Slinta/Hardware/Black_STM32F407VET6/STM32F407VET6.kicad_pcb

## KiCad design Black_STM32F407VET6/STM32F407VET6.kicad_pcb (2019-08-13)

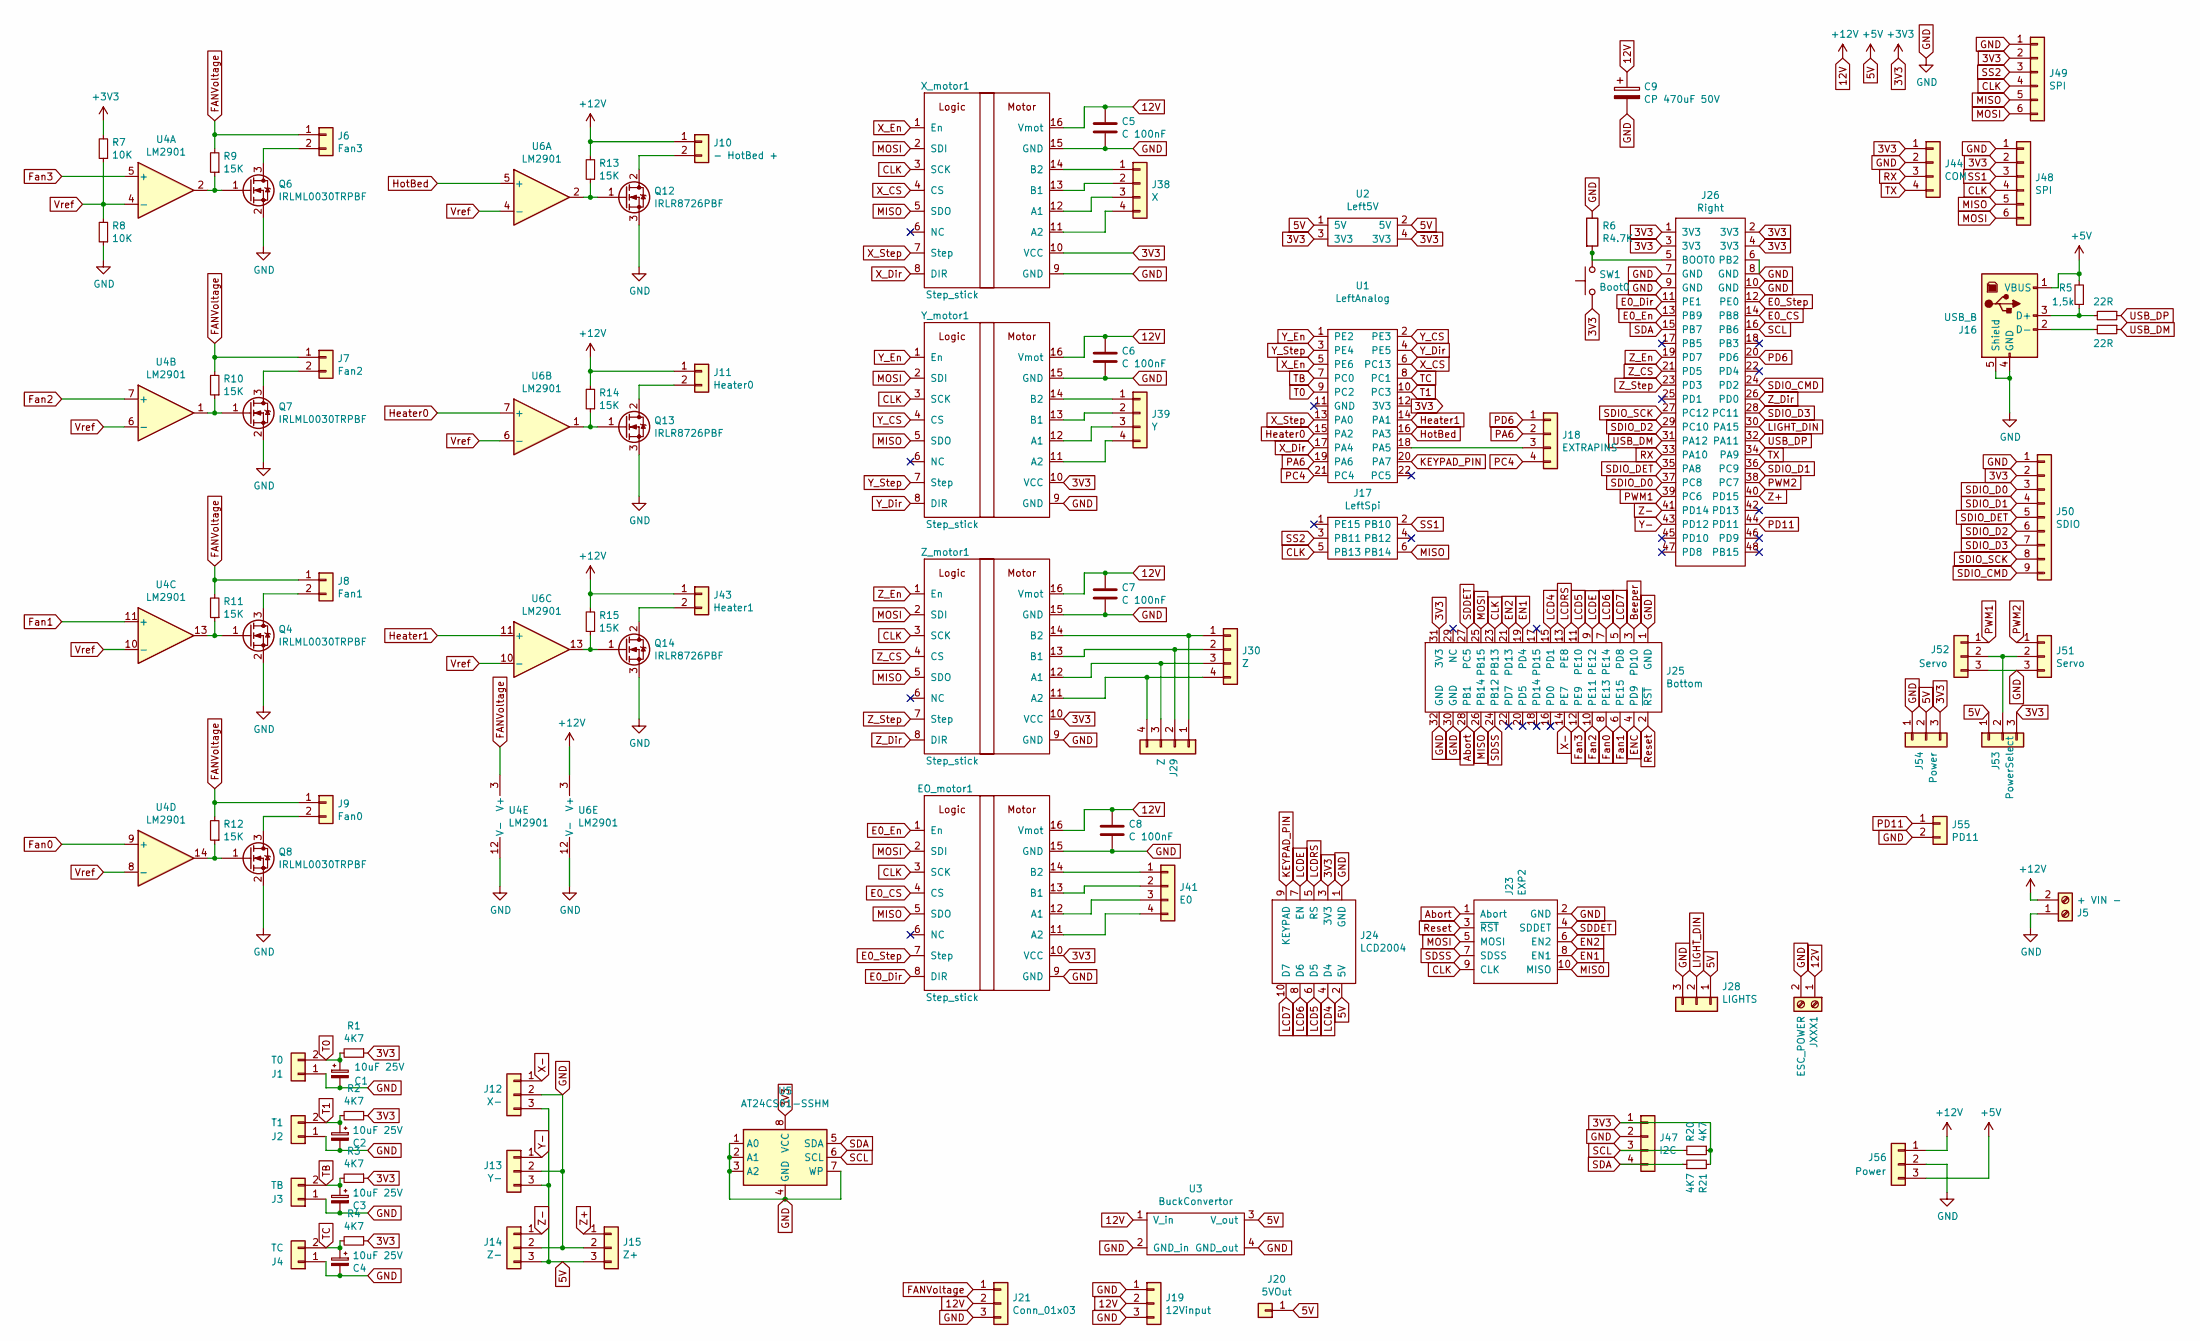
[picture p1: schematic STM32F407VET6.sch]

Parts:
C1, C2, C3, C4: 10uF 25V; CP_Radial_D4.0mm_P2.00mm
C5, C6, C7, C8: C 100nF; C_Disc_D3.4mm_W2.1mm_P2.50mm
C9: CP 470uF 50V; CP_Radial_D10.0mm_P5.00mm
EO_motor1: Step_stick; Motor
J1: T0; JST_XH_B2B-XH-AM_1x02_P2.50mm_Vertical
J2: T1; JST_XH_B2B-XH-AM_1x02_P2.50mm_Vertical
J3: TB; JST_XH_B2B-XH-AM_1x02_P2.50mm_Vertical
J4: TC; JST_XH_B2B-XH-AM_1x02_P2.50mm_Vertical
J5: + VIN -; KF7.62_2P
J6: Fan3; JST_XH_B2B-XH-AM_1x02_P2.50mm_Vertical
J7: Fan2; JST_XH_B2B-XH-AM_1x02_P2.50mm_Vertical
J8: Fan1; JST_XH_B2B-XH-AM_1x02_P2.50mm_Vertical
J9: Fan0; JST_XH_B2B-XH-AM_1x02_P2.50mm_Vertical
J10: - HotBed +; KF7.62_2P
J11: Heater0; TerminalBlock_bornier-2_P5.08mm
J12: X-; JST_XH_B3B-XH-A_1x03_P2.50mm_Vertical
J13: Y-; JST_XH_B3B-XH-A_1x03_P2.50mm_Vertical
J14: Z-; JST_XH_B3B-XH-A_1x03_P2.50mm_Vertical
J15: Z+; JST_XH_B3B-XH-A_1x03_P2.50mm_Vertical
J16: USB_B; USB_B_OST_USB-B1HSxx_Horizontal
J17: LeftSpi; PinHeader_2x03_P2.54mm_Vertical
J18: EXTRAPINS; PinHeader_1x04_P2.54mm_Vertical
J19: 12Vinput; PinHeader_1x03_P2.54mm_Vertical
J20: 5VOut; PinHeader_1x01_P2.54mm_Vertical
J21: Conn_01x03; PinHeader_1x03_P2.54mm_Vertical
J23: EXP2; IDC-Header_2x05_P2.54mm_Vertical
J24: LCD2004; IDC-Header_2x05_P2.54mm_Vertical
J25: Bottom; PinSocket_2x16_P2.54mm_Vertical
J26: Right; PinSocket_2x24_P2.54mm_Vertical
J28: LIGHTS; JST_XH_B3B-XH-A_1x03_P2.50mm_Vertical
J29, J30: Z; JST_XH_B4B-XH-A_1x04_P2.50mm_Vertical
J38: X; JST_XH_B4B-XH-A_1x04_P2.50mm_Vertical
J39: Y; JST_XH_B4B-XH-A_1x04_P2.50mm_Vertical
J41: E0; JST_XH_B4B-XH-A_1x04_P2.50mm_Vertical
J43: Heater1; TerminalBlock_bornier-2_P5.08mm
J44: COM; PinHeader_1x04_P2.54mm_Vertical
J47: I2C; PinHeader_1x04_P2.54mm_Vertical
J48, J49: SPI; PinHeader_1x06_P2.54mm_Vertical
J50: SDIO; JST_XH_B9B-XH-A_1x09_P2.50mm_Vertical
J51, J52: Servo; PinHeader_1x03_P2.54mm_Vertical
J53: PowerSelect; PinHeader_1x03_P2.54mm_Vertical
J54, J56: Power; PinHeader_1x03_P2.54mm_Vertical
J55: PD11; PinHeader_1x02_P2.54mm_Vertical
JXXX1: ESC_POWER; TerminalBlock_bornier-2_P5.08mm
Q4, Q6, Q7, Q8: IRLML0030TRPBF; SOT-23
Q12, Q13, Q14: IRLR8726PBF; TO-252-2
R1, R2, R3, R4, R20, R21: 4K7; R_0603_1608Metric
R5: 1,5k; R_0603_1608Metric
R6: R4.7K; R_0603_1608Metric
R7, R8: 10K; R_0603_1608Metric
R9, R10, R11, R12, R13, R14, R15: 15K; R_0603_1608Metric
R18, R19: 22R; R_0603_1608Metric
SW1: Boot0; SW_PUSH_6mm_H5mm
U1: LeftAnalog; PinHeader_2x11_P2.54mm_Vertical
U2: Left5V; PinHeader_2x02_P2.54mm_Vertical
U3: BuckConvertor; MP2307Buck
U4, U6: LM2901; SOIC-14_3.9x8.7mm_P1.27mm
U5: AT24CS01-SSHM; SOIC-8_3.9x4.9mm_P1.27mm
X_motor1: Step_stick; Motor
Y_motor1: Step_stick; Motor
Z_motor1: Step_stick; Motor

Connections:
3V3: EO_motor1.10 (VCC), J24.3 (3V3), J25.31 (3V3), J26.1 (3V3), J26.2 (3V3), J26.3 (3V3), J26.4 (3V3), J44.1, J47.1, J48.2, J49.2, J50.2, J53.3, J54.3, R1.1, R2.1, R3.1, R4.1, R7.2, R20.1, R21.2, SW1.1, U1.12 (3V3), U2.3 (3V3), U2.4 (3V3), U5.8 (VCC), X_motor1.10 (VCC), Y_motor1.10 (VCC), Z_motor1.10 (VCC)
5V: J12.3, J13.3, J14.3, J15.3, J16.1 (VBUS), J20.1, J24.2 (5V), J28.1, J53.1, J54.2, J56.3, R5.2, U2.1 (5V), U2.2 (5V), U3.3 (V_out)
12V: C5.1, C6.1, C7.1, C8.1, C9.1, EO_motor1.16 (Vmot), J5.2, J10.1, J11.1, J19.2, J21.2, J43.1, J56.1, JXXX1.1, R13.2, R14.2, R15.2, U3.1 (V_in), U6.3 (V+), X_motor1.16 (Vmot), Y_motor1.16 (Vmot), Z_motor1.16 (Vmot)
Abort: J23.1 (Abort), J25.28 (PB1)
Beeper: J25.3 (PD10)
CLK: EO_motor1.3 (SCK), J17.5 (PB13), J23.9 (CLK), J25.23 (PB13), J48.4, J49.4, X_motor1.3 (SCK), Y_motor1.3 (SCK), Z_motor1.3 (SCK)
E0_CS: EO_motor1.4 (CS), J26.14 (PB8)
E0_Dir: EO_motor1.8 (DIR), J26.11 (PE1)
E0_En: EO_motor1.1 (En), J26.13 (PB9)
E0_Step: EO_motor1.7 (Step), J26.12 (PE0)
EN1: J23.8 (EN1), J25.19 (PD4)
EN2: J23.6 (EN2), J25.21 (PD13)
ENC: J25.4 (PD9)
FANVoltage: J6.1, J7.1, J8.1, J9.1, J21.1, R9.2, R10.2, R11.2, R12.2, U4.3 (V+)
Fan0: J25.8 (PE13), U4.9 (+)
Fan1: J25.6 (PE15), U4.11 (+)
Fan2: J25.10 (PE11), U4.7 (+)
Fan3: J25.12 (PE9), U4.5 (+)
GND: C1.2, C2.2, C3.2, C4.2, C5.2, C6.2, C7.2, C8.2, C9.2, EO_motor1.9 (GND), EO_motor1.15 (GND), J1.1, J2.1, J3.1, J4.1, J5.1, J12.2, J13.2, J14.2, J15.2, J16.4 (GND), J16.5 (Shield), J19.1, J19.3, J21.3, J23.2 (GND), J24.1 (GND), J25.1 (GND), J25.30 (GND), J25.32 (GND), J26.6 (PB2), J26.7 (GND), J26.8 (GND), J26.9 (GND), J26.10 (GND), J28.3, J44.2, J47.2, J48.1, J49.1, J50.1, J51.3, J52.3, J54.1, J55.2, J56.2, JXXX1.2, Q4.2 (S), Q6.2 (S), Q7.2 (S), Q8.2 (S), Q12.3 (S), Q13.3 (S), Q14.3 (S), R6.1, R8.1, U3.2 (GND_in), U3.4 (GND_out), U4.12 (V-), U5.1 (A0), U5.2 (A1), U5.3 (A2), U5.4 (GND), U5.7 (WP), U6.12 (V-), X_motor1.9 (GND), X_motor1.15 (GND), Y_motor1.9 (GND), Y_motor1.15 (GND), Z_motor1.9 (GND), Z_motor1.15 (GND)
Heater0: U1.15 (PA2), U6.7 (+)
Heater1: U1.14 (PA1), U6.11 (+)
HotBed: U1.16 (PA3), U6.5 (+)
KEYPAD_PIN: J24.9 (KEYPAD), U1.20 (PA7)
LCD4: J24.4 (D4), J25.15 (PD1)
LCD5: J24.6 (D5), J25.11 (PE10)
LCD6: J24.8 (D6), J25.7 (PE14)
LCD7: J24.10 (D7), J25.5 (PD8)
LCDE: J24.7 (EN), J25.9 (PE12)
LCDRS: J24.5 (RS), J25.13 (PE8)
LIGHT_DIN: J26.30 (PA15), J28.2
MISO: EO_motor1.5 (SDO), J17.6 (PB14), J23.10 (MISO), J25.26 (PB14), J48.5, J49.5, X_motor1.5 (SDO), Y_motor1.5 (SDO), Z_motor1.5 (SDO)
MOSI: EO_motor1.2 (SDI), J23.5 (MOSI), J25.25 (PB15), J48.6, J49.6, X_motor1.2 (SDI), Y_motor1.2 (SDI), Z_motor1.2 (SDI)
unnamed: EO_motor1.11 (A2), J41.4
unnamed: EO_motor1.12 (A1), J41.3
unnamed: EO_motor1.13 (B1), J41.2
unnamed: EO_motor1.14 (B2), J41.1
unnamed: J6.2, Q6.3 (D)
unnamed: J7.2, Q7.3 (D)
unnamed: J8.2, Q4.3 (D)
unnamed: J9.2, Q8.3 (D)
unnamed: J10.2, Q12.2 (D)
unnamed: J11.2, Q13.2 (D)
unnamed: J16.2 (D-), R18.2
unnamed: J16.3 (D+), R5.1, R19.2
unnamed: J18.3, U1.18 (PA5)
unnamed: J26.5 (BOOT0), R6.2, SW1.2
unnamed: J29.1, J30.1, Z_motor1.14 (B2)
unnamed: J29.2, J30.2, Z_motor1.13 (B1)
unnamed: J29.3, J30.3, Z_motor1.12 (A1)
unnamed: J29.4, J30.4, Z_motor1.11 (A2)
unnamed: J38.1, X_motor1.14 (B2)
unnamed: J38.2, X_motor1.13 (B1)
unnamed: J38.3, X_motor1.12 (A1)
unnamed: J38.4, X_motor1.11 (A2)
unnamed: J39.1, Y_motor1.14 (B2)
unnamed: J39.2, Y_motor1.13 (B1)
unnamed: J39.3, Y_motor1.12 (A1)
unnamed: J39.4, Y_motor1.11 (A2)
unnamed: J43.2, Q14.2 (D)
unnamed: J51.2, J52.2, J53.2
unnamed: Q4.1 (G), R11.1, U4.13
unnamed: Q6.1 (G), R9.1, U4.2
unnamed: Q7.1 (G), R10.1, U4.1
unnamed: Q8.1 (G), R12.1, U4.14
unnamed: Q12.1 (G), R13.1, U6.2
unnamed: Q13.1 (G), R14.1, U6.1
unnamed: Q14.1 (G), R15.1, U6.13
PA6: J18.2, U1.19 (PA6)
PC4: J18.4, U1.21 (PC4)
PD6: J18.1, J26.20 (PD6)
PD11: J26.44 (PD11), J55.1
PWM1: J26.39 (PC6), J52.1
PWM2: J26.38 (PC7), J51.1
RX: J26.33 (PA10), J44.3
Reset: J23.3 (~RST), J25.2 (~RST)
SCL: J26.16 (PB6), J47.3, R20.2, U5.6 (SCL)
SDA: J26.15 (PB7), J47.4, R21.1, U5.5 (SDA)
SDDET: J23.4 (SDDET), J25.27 (PC5)
SDIO_CMD: J26.24 (PD2), J50.9
SDIO_D0: J26.37 (PC8), J50.3
SDIO_D1: J26.36 (PC9), J50.4
SDIO_D2: J26.29 (PC10), J50.6
SDIO_D3: J26.28 (PC11), J50.7
SDIO_DET: J26.35 (PA8), J50.5
SDIO_SCK: J26.27 (PC12), J50.8
SDSS: J23.7 (SDSS), J25.24 (PB12)
SS1: J17.2 (PB10), J48.3
SS2: J17.3 (PB11), J49.3
T0: C1.1, J1.2, R1.2, U1.9 (PC2)
T1: C2.1, J2.2, R2.2, U1.10 (PC3)
TB: C3.1, J3.2, R3.2, U1.7 (PC0)
TC: C4.1, J4.2, R4.2, U1.8 (PC1)
TX: J26.34 (PA9), J44.4
USB_DM: J26.31 (PA12), R18.1
USB_DP: J26.32 (PA11), R19.1
Vref: R7.1, R8.2, U4.4 (-), U4.6 (-), U4.8 (-), U4.10 (-), U6.4 (-), U6.6 (-), U6.10 (-)
X-: J12.1, J25.14 (PE7)
X_CS: U1.6 (PC13), X_motor1.4 (CS)
X_Dir: U1.17 (PA4), X_motor1.8 (DIR)
X_En: U1.5 (PE6), X_motor1.1 (En)
X_Step: U1.13 (PA0), X_motor1.7 (Step)
Y-: J13.1, J26.43 (PD12)
Y_CS: U1.2 (PE3), Y_motor1.4 (CS)
Y_Dir: U1.4 (PE5), Y_motor1.8 (DIR)
Y_En: U1.1 (PE2), Y_motor1.1 (En)
Y_Step: U1.3 (PE4), Y_motor1.7 (Step)
Z+: J15.1, J26.40 (PD15)
Z-: J14.1, J26.41 (PD14)
Z_CS: J26.21 (PD5), Z_motor1.4 (CS)
Z_Dir: J26.26 (PD0), Z_motor1.8 (DIR)
Z_En: J26.19 (PD7), Z_motor1.1 (En)
Z_Step: J26.23 (PD3), Z_motor1.7 (Step)

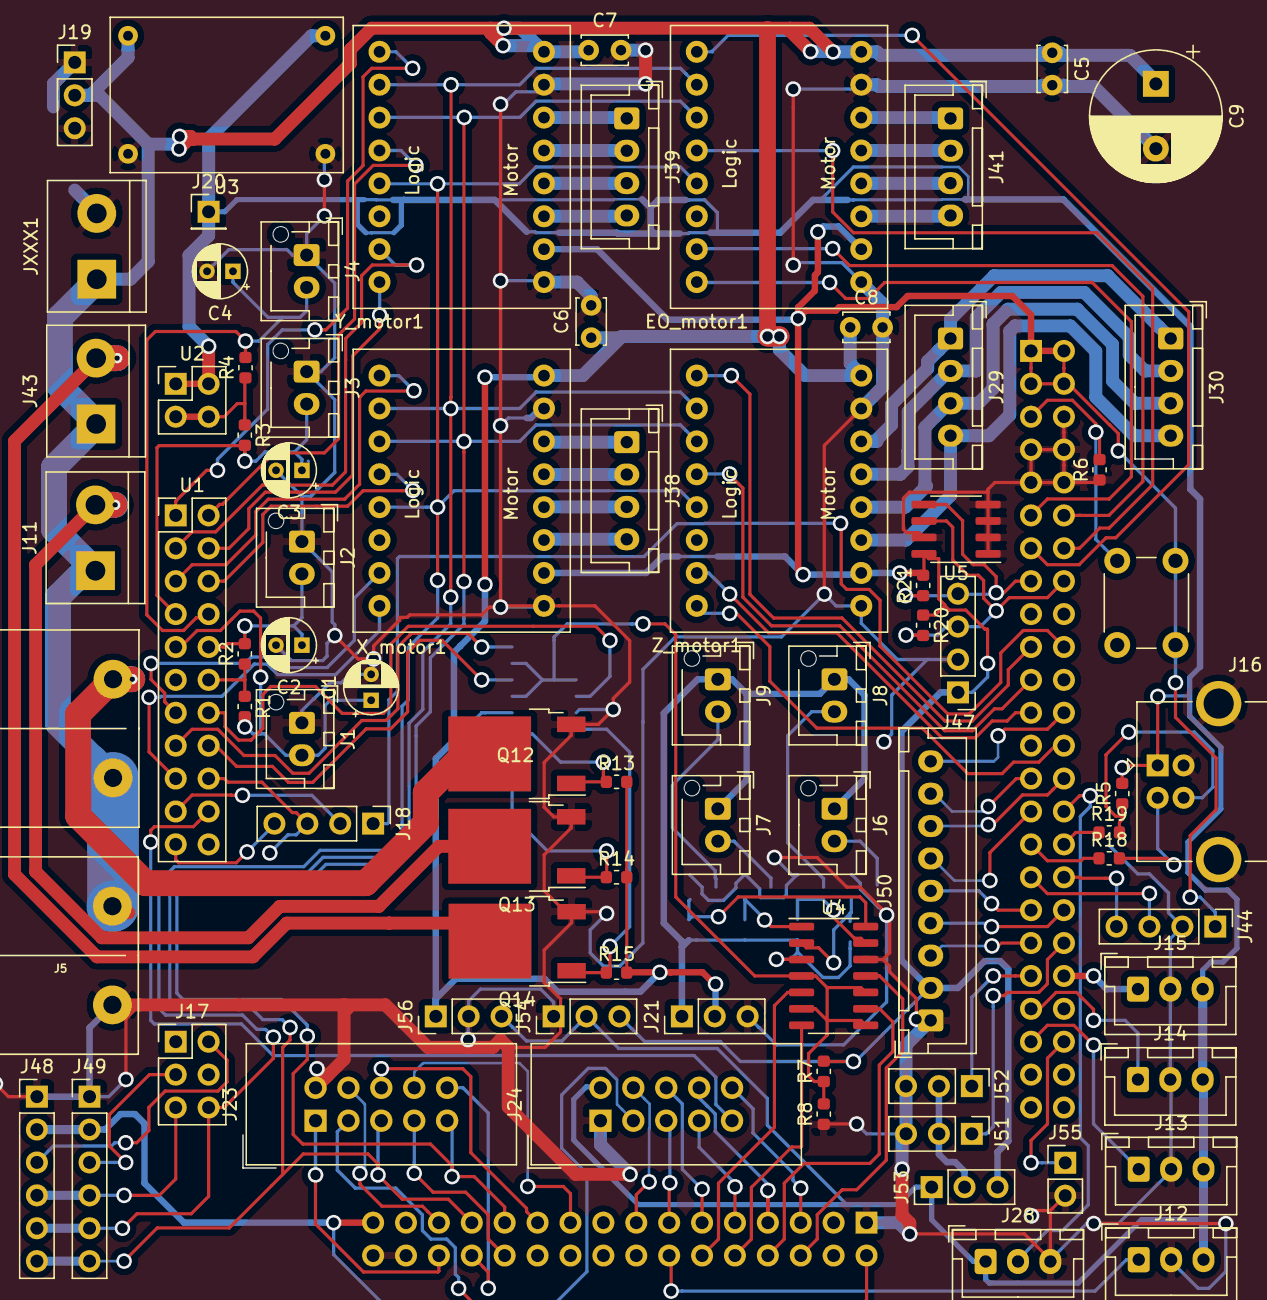
[picture p2: board STM32F407VET6.kicad_pcb from above]

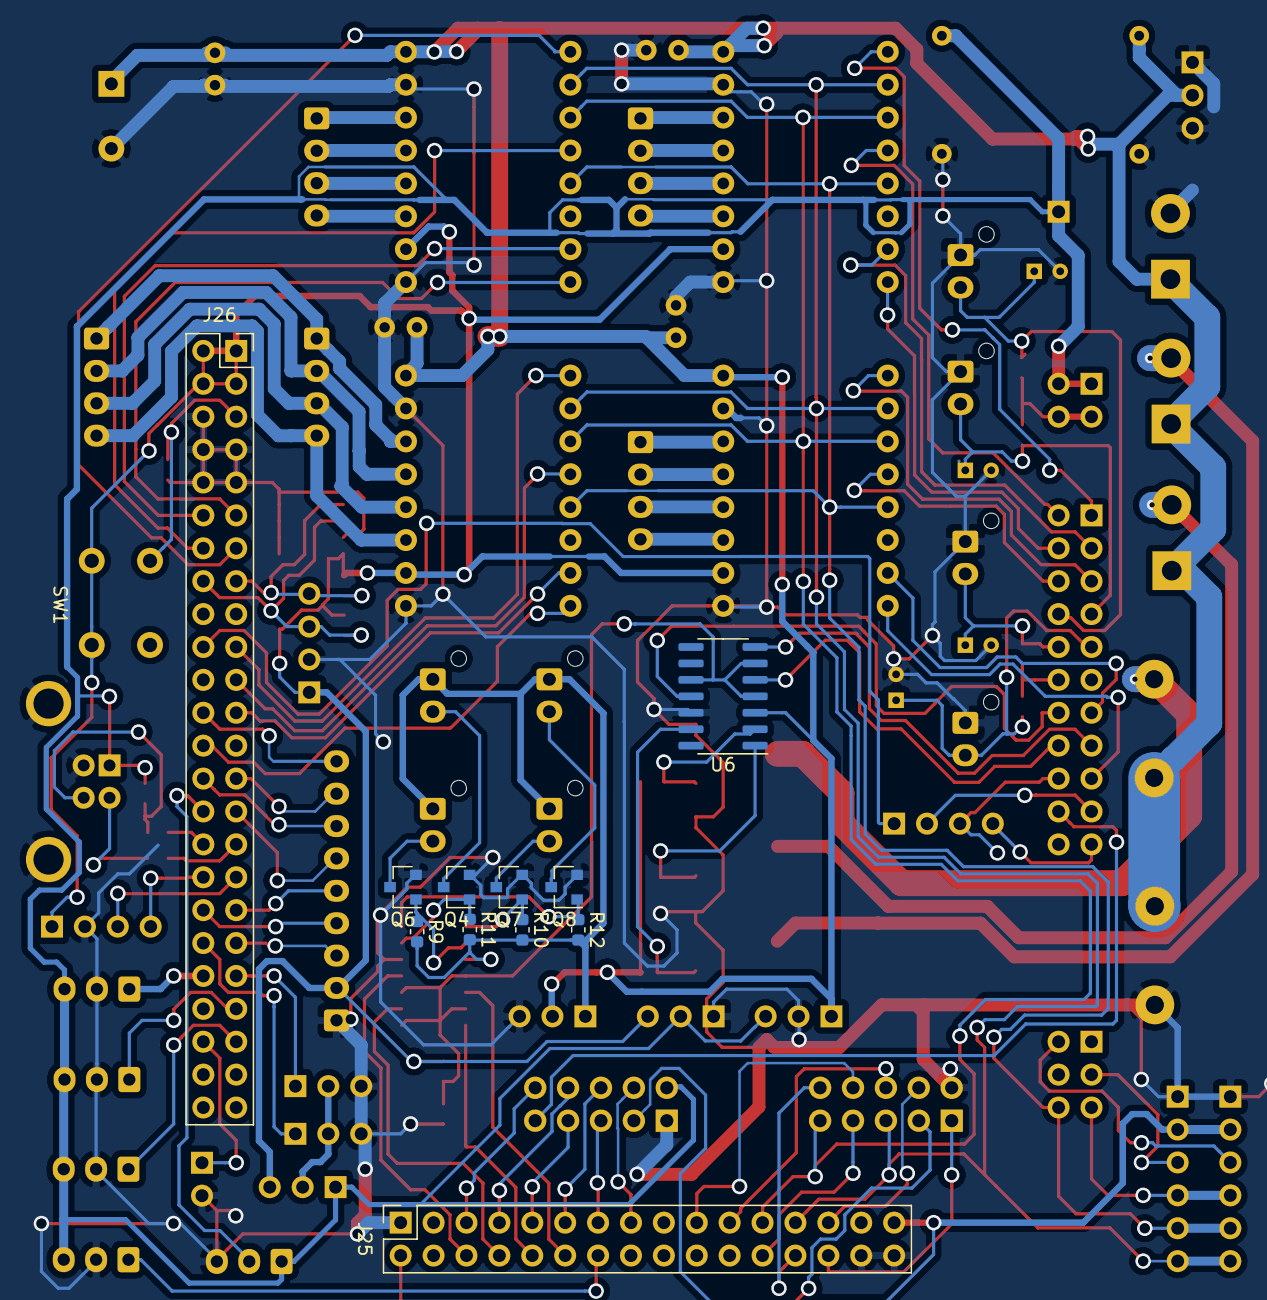
[picture p3: board STM32F407VET6.kicad_pcb from below]

Board: 2 copper layers, 90 parts (11 on the bottom side), 110 nets.
