Slinta/Hardware/(commit log)

2019-07-08 Schematic only: TMC spi, ESC pins etc.
2019-07-09 Changed parts in schematic to be cheaper, PCB changed to be DIY friendly
    [STM32F407VET6.kicad_pcb]
2019-07-09 Arranged parts on PCB, swapped a few pins in schematic to align connectors.
    [STM32F407VET6.kicad_pcb, STM32F407VET6.sch]
2019-07-12 Flash button, Endstops, Drivers moved
    [STM32F407VET6.kicad_pcb, STM32F407VET6.sch]
2019-07-13 Rework of the PCB, made footprint for the motor drivers.
    [STM32F407VET6.kicad_pcb, STM32F407VET6.sch]
2019-07-13 Power connectors - Removed left side holes to make room for Heater and Bed traces - Moved spi connectors, temperature connectors, fan connectors - Assigned correct footprints to power connectors (KF7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
    [STM32F407VET6.kicad_pcb, STM32F407VET6.sch]
2019-07-14 Left side - Temperature sensors - Capacitor package change - Reworked left side symbols
    [STM32F407VET6-B.Cu.gbr, STM32F407VET6-B.Mask.gbr, STM32F407VET6-B.SilkS.gbr, STM32F407VET6-Edge.Cuts.gbr, STM32F407VET6-F.Cu.gbr, STM32F407VET6-F.Mask.gbr, STM32F407VET6-F.SilkS.gbr, STM32F407VET6.drl]
2019-07-15 Layout finialized - finished fan section - fixed & finished temperature section - drivers positioned roughly
    [STM32F407VET6.kicad_pcb, STM32F407VET6.sch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]
2019-07-17 Changed spi channel, updated design rules TODO: change all tracks to be at least 0.25 wide and fix tracks not being in the center between headers
    [STM32F407VET6.kicad_pcb, STM32F407VET6.sch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]
2019-07-18 Wider tracks, more clearance, X & Y logic. SPI 1 is no longer used on shield because is used on the mcu board with different pins Added a design rule, distance between tracks is now at least 0.2925 W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
    [STM32F407VET6.kicad_pcb, STM32F407VET6.sch]
2019-07-18 Z and E0 wiring - 12V rails - TODO: spi lines
    [STM32F407VET6.kicad_pcb, STM32F407VET6.sch]
2019-07-18 Power lines
    [STM32F407VET6.kicad_pcb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]
2019-07-19 Power mosfets - everything done apart from connecting GND - Are the 12V rail caps necessary ?
    [STM32F407VET6.kicad_pcb, STM32F407VET6.sch]
2019-07-24 Flipped back resistors to the front
    [STM32F407VET6.kicad_pcb, STM32F407VET6.sch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]
2019-07-31 Added comparators to drive the mosfets.
    [STM32F407VET6.kicad_pcb, STM32F407VET6.sch]
2019-08-03 Board layout with the opamps
    [STM32F407VET6.kicad_pcb, STM32F407VET6.sch]
2019-08-07 Added fill zones
    [STM32F407VET6.kicad_pcb, STM32F407VET6.sch]
2019-08-13 Fan 12V rail separated with option for buck disabled board outline for manufacturing - moved to fab layer
    [STM32F407VET6-B_Cu.gbr, STM32F407VET6-F_Cu.gbr, STM32F407VET6-NPTH.drl, STM32F407VET6-PTH.drl]
2019-08-13 //Forgot to save Fan separated power rail to allow different voltage Moved border to fabrication layer to prepare for milling
    [STM32F407VET6.kicad_pcb, STM32F407VET6.sch]
